maxeo/3dprint-supporto-tablet/stl/supporto_assemblato.stl

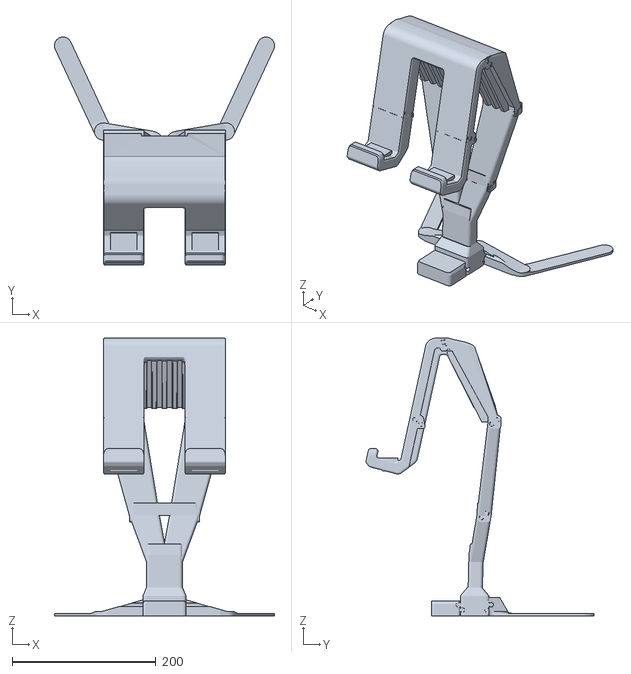
[picture p1: CAD file, 2026-09-29]
stl/supporto_assemblato.stl
306.5 x 317.3 x 386.9
