maxeo/3dprint-supporto-tablet/originale/obj_1_raised_phone_stand2.stl

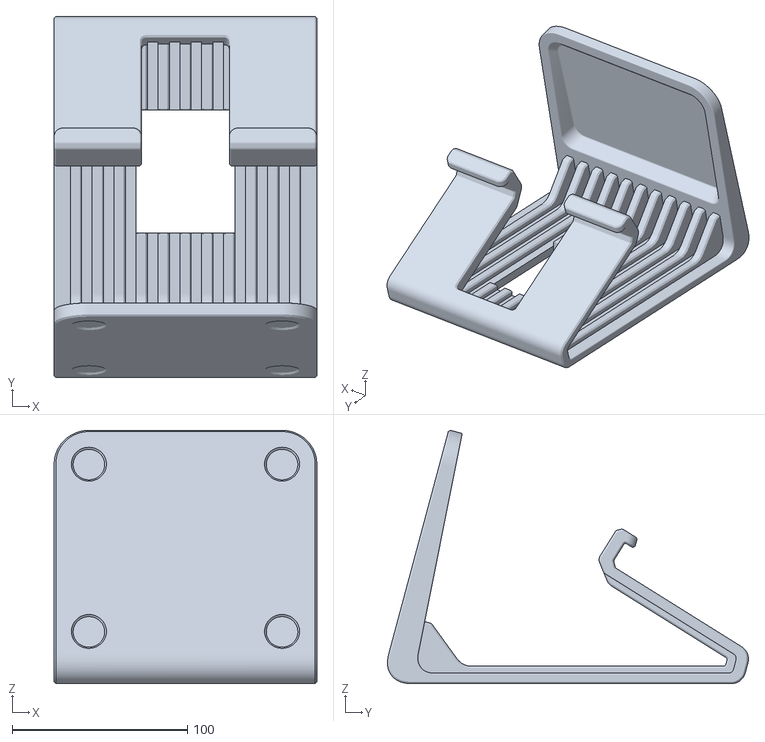
[picture p2: CAD file, 2026-09-13]
originale/obj_1_raised_phone_stand2.stl
150.0 x 206.1 x 144.6
