maxeo/3dprint-supporto-tablet/prove/provino_B_x1.stl

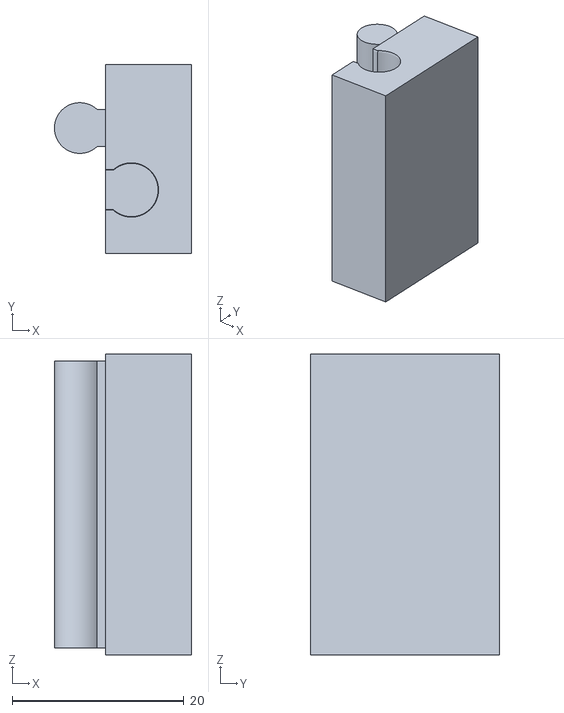
[picture p3: CAD file, 2026-09-13]
prove/provino_B_x1.stl
16.0 x 22.0 x 35.0
