maxeo/3dprint-supporto-tablet/stl/pezzi_singoli/B01_piede_anteriore_corto_x1.stl

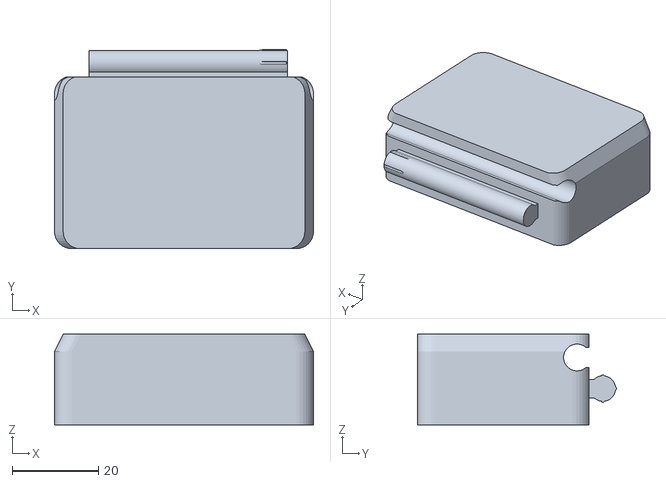
[picture p4: CAD file, 2026-09-29]
stl/pezzi_singoli/B01_piede_anteriore_corto_x1.stl
60.0 x 46.2 x 21.0
