maxeo/3dprint-supporto-tablet/stl/tutti_i_pezzi_separati.stl

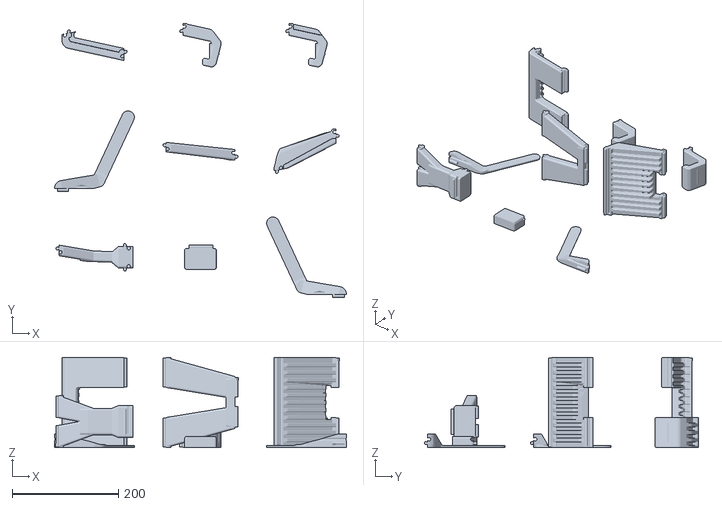
[picture p5: CAD file, 2026-09-29]
stl/tutti_i_pezzi_separati.stl
550.7 x 517.6 x 170.0
