maxeo/3dprint-supporto-tablet/stl/varianti/S05_schienale_unico_x1.stl

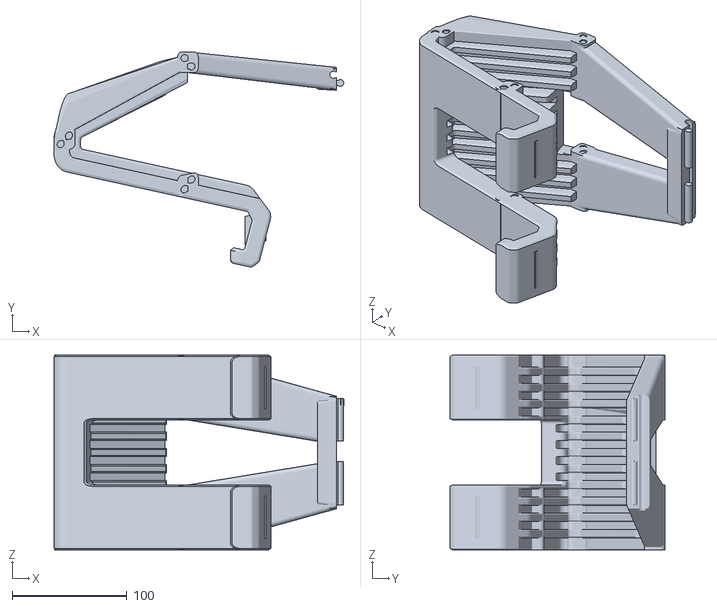
[picture p6: CAD file, 2026-09-29]
stl/varianti/S05_schienale_unico_x1.stl
253.1 x 187.8 x 170.0
