maxeo/3dprint-supporto-tablet/prove/provino_A_x1.stl

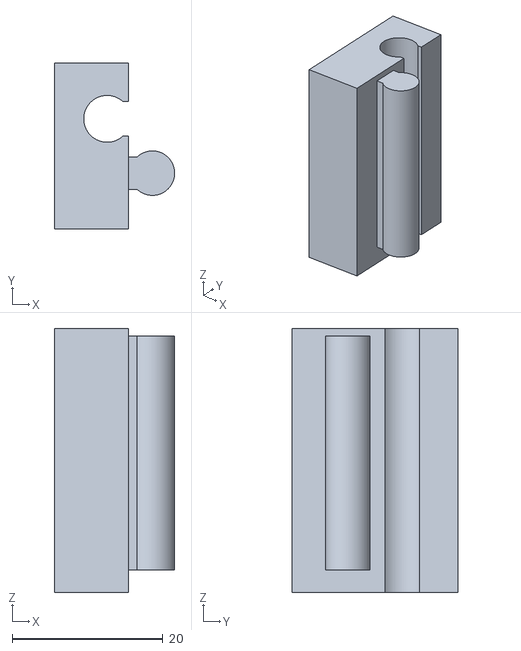
[picture p7: CAD file, 2026-09-13]
prove/provino_A_x1.stl
16.0 x 22.0 x 35.0
