maxeo/3dprint-supporto-tablet/stl/pezzi_singoli/A01_appoggio_sinistro_x1.stl

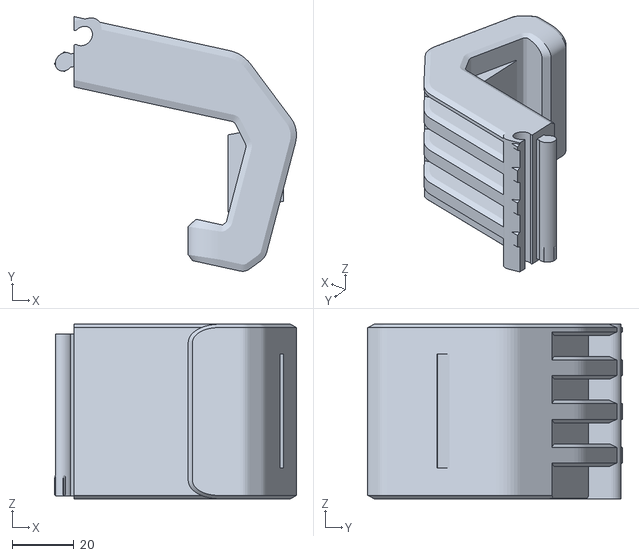
[picture p8: CAD file, 2026-09-29]
stl/pezzi_singoli/A01_appoggio_sinistro_x1.stl
78.5 x 82.6 x 56.7
