maxeo/3dprint-supporto-tablet/stl/varianti/A03_appoggio_unico_x1.stl

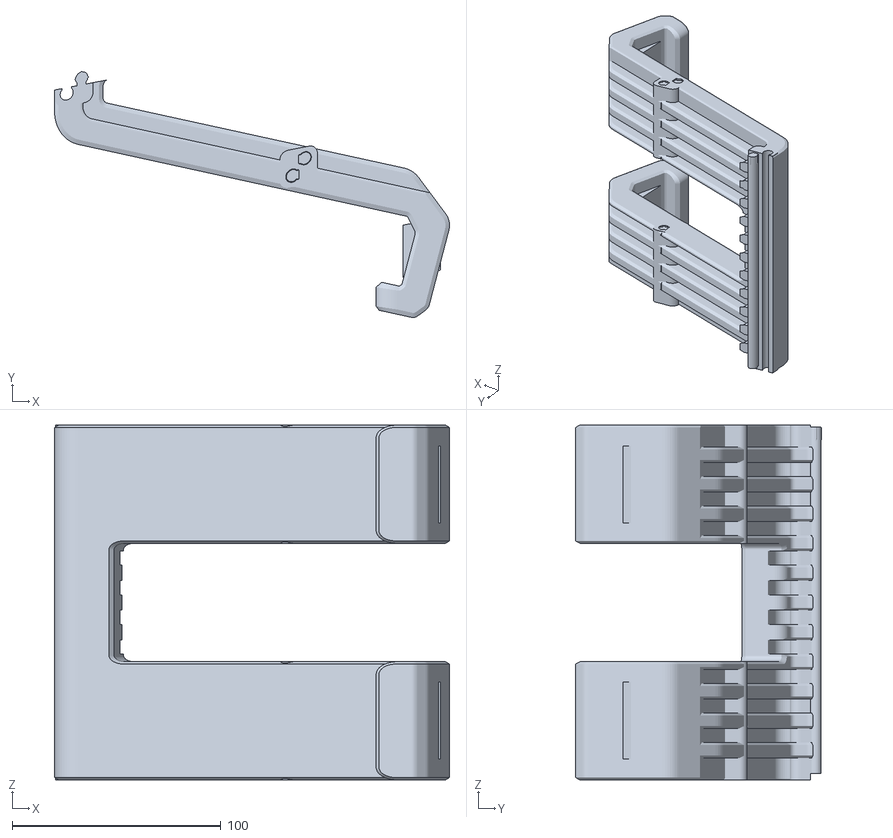
[picture p9: CAD file, 2026-09-29]
stl/varianti/A03_appoggio_unico_x1.stl
189.2 x 117.9 x 170.0
