maxeo/3dprint-supporto-tablet/stl/pezzi_singoli/S01_schienale_a_y_x1.stl

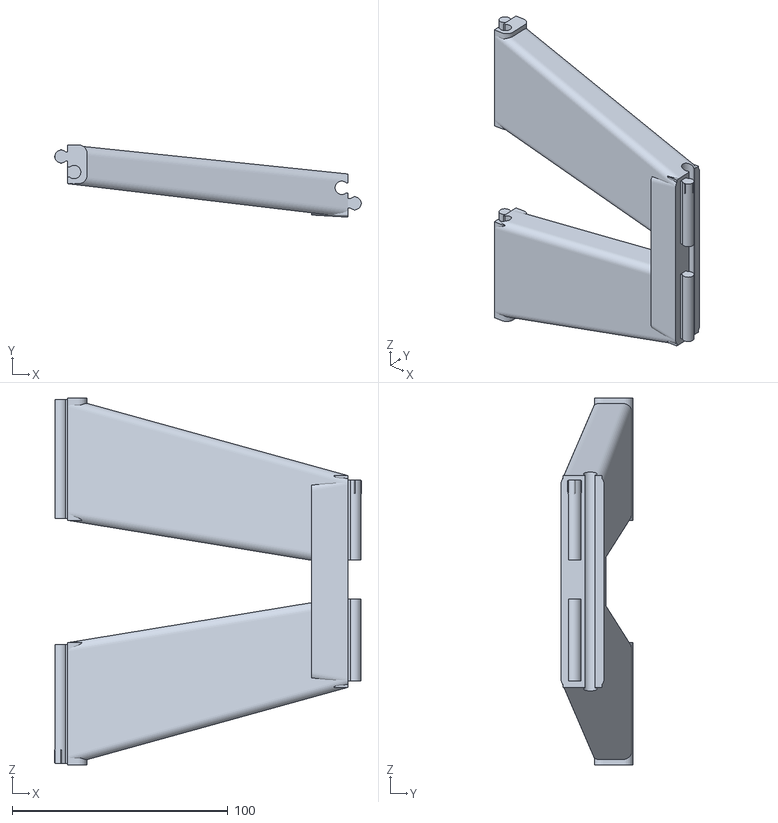
[picture p10: CAD file, 2026-09-29]
stl/pezzi_singoli/S01_schienale_a_y_x1.stl
142.4 x 33.5 x 170.0
