maxeo/3dprint-supporto-tablet/stl/varianti/B06_raccordo_con_piede_x1.stl

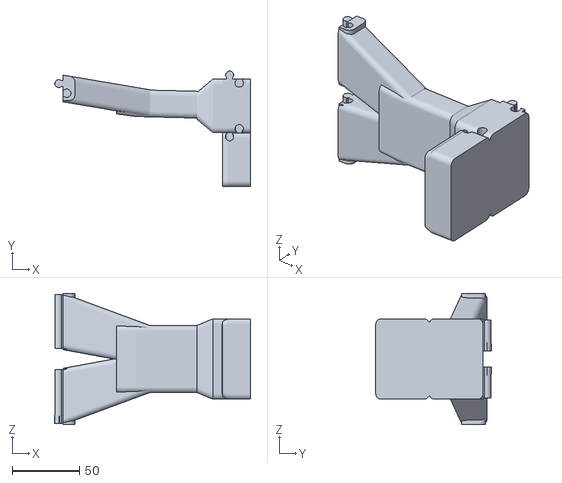
[picture p11: CAD file, 2026-09-29]
stl/varianti/B06_raccordo_con_piede_x1.stl
146.2 x 86.2 x 98.0
