maxeo/3dprint-supporto-tablet/stl/pezzi_singoli/B05_gamba_posteriore_destra_x1.stl

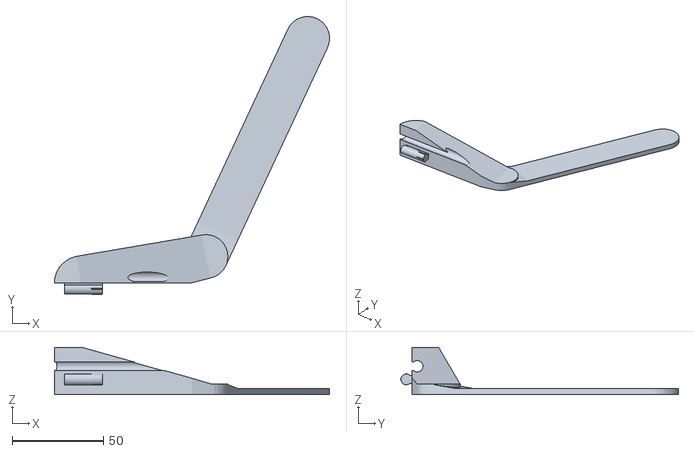
[picture p12: CAD file, 2026-09-29]
stl/pezzi_singoli/B05_gamba_posteriore_destra_x1.stl
150.7 x 152.3 x 26.0
