maxeo/3dprint-supporto-tablet/stl/varianti/S04_testa_unica_x1.stl

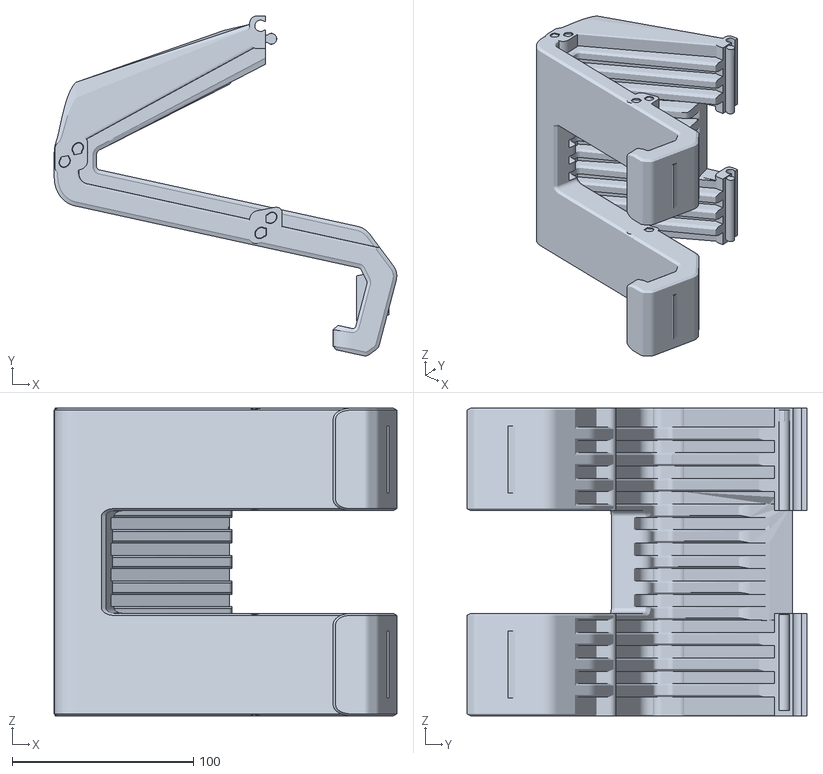
[picture p13: CAD file, 2026-09-29]
stl/varianti/S04_testa_unica_x1.stl
189.2 x 187.8 x 170.0
