maxeo/3dprint-supporto-tablet/stl/pezzi_singoli/S03_appoggio_superiore_anteriore_x1.stl

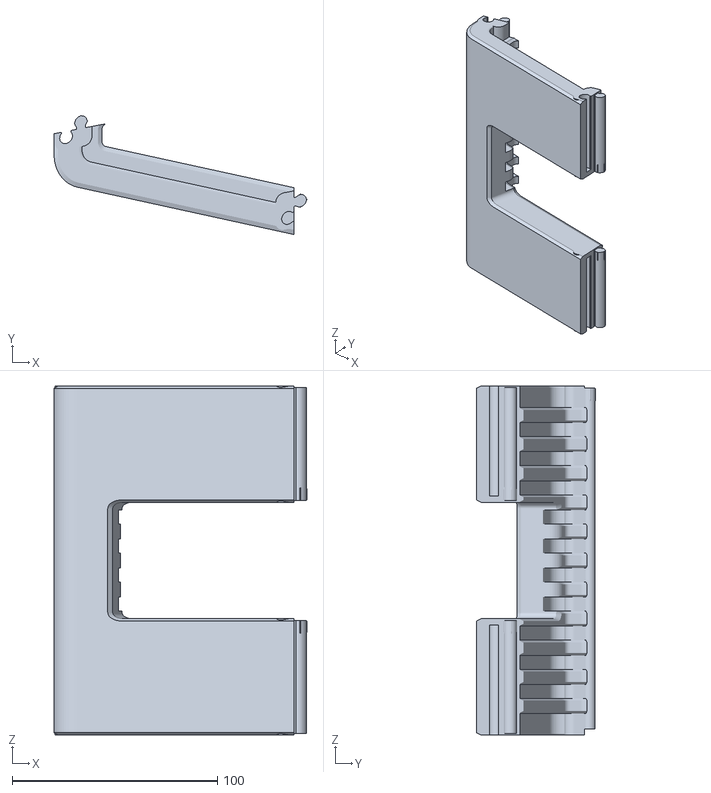
[picture p14: CAD file, 2026-09-29]
stl/pezzi_singoli/S03_appoggio_superiore_anteriore_x1.stl
123.1 x 58.0 x 170.0
