maxeo/3dprint-supporto-tablet/stl/pezzi_singoli/B03_raccordo_centrale_blu_x1.stl

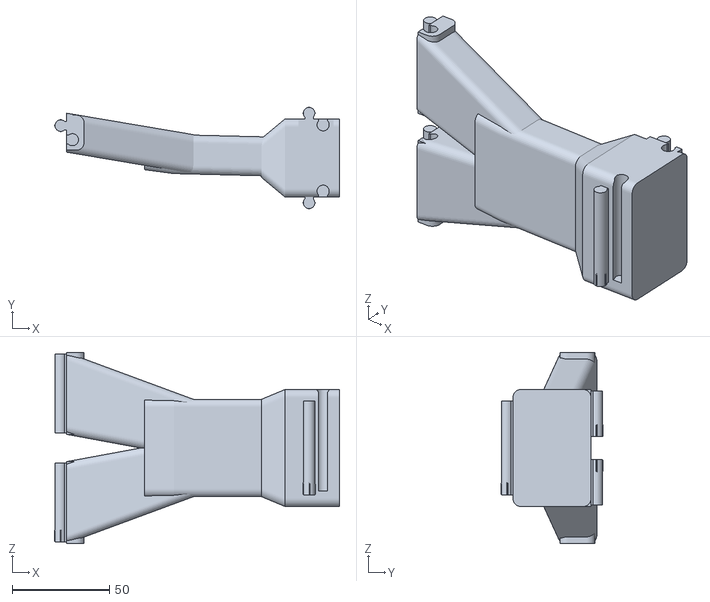
[picture p15: CAD file, 2026-09-29]
stl/pezzi_singoli/B03_raccordo_centrale_blu_x1.stl
146.2 x 52.4 x 98.0
