maxeo/3dprint-supporto-tablet/stl/pezzi_singoli/S02_schienale_superiore_posteriore_x1.stl

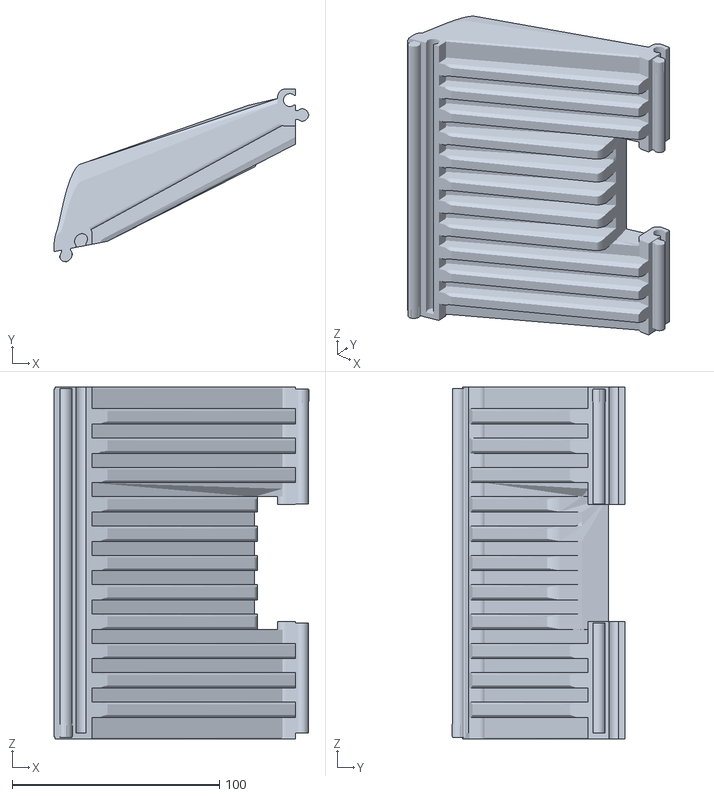
[picture p16: CAD file, 2026-09-29]
stl/pezzi_singoli/S02_schienale_superiore_posteriore_x1.stl
123.1 x 83.7 x 170.0
