maxeo/3dprint-supporto-tablet/(list of files, cad)

Other CAD files:
prove/tolleranze/V7_G015CR_B_nervature.stl
prove/tolleranze/V7_G015CR_A_nervature.stl
prove/tolleranze/V7_G015_A_piolo_maggiorato.stl
prove/tolleranze/V7_G015_B_piolo_maggiorato.stl
prove/tolleranze/V7_G010_B_piolo_maggiorato.stl
prove/tolleranze/V7_G010_A_piolo_maggiorato.stl
stl/pezzi_singoli/A02_appoggio_destro_x1.stl
stl/pezzi_singoli/B04_gamba_posteriore_sinistra_x1.stl
blender/supporto_22cm.blend
prove/tolleranze/provini_G015CR.blend
