maxeo/3dprint-supporto-tablet/(commit log)

2026-09-13 Aggiunto il README con il link alla guida online
    - Aggiunto il collegamento alla guida pubblicata su GitHub Pages
    - Descritti i contenuti delle cartelle del progetto
2026-09-26 Riorganizzati i file del progetto in cartelle
    - Spostati gli STL in stl, il blend in blender e i JSON in dati
    - Spostati istruzioni e SVG in documenti
    - Aggiornati i percorsi in guida, README e JSON
    [A01_appoggio_sinistro_x1.stl, A02_appoggio_destro_x1.stl, B01_piede_anteriore_corto_x1.stl, B03_raccordo_centrale_blu_x1.stl, B04_gamba_posteriore_sinistra_x1.stl, B05_gamba_posteriore_destra_x1.stl, S01_schienale_a_y_x1.stl, S02_schienale_superiore_posteriore_x1.stl]
2026-09-26 Aggiunto il tema chiaro e scuro alla guida
    - Pulsante Sistema, Chiaro, Scuro con scelta condivisa tra le guide
2026-09-27 Aggiunto il pulsante Stampante alla guida
    - Area di stampa condivisa fra le guide e avviso sui pezzi che non entrano
2026-09-27 Aggiornato il controllo della stampante nella guida
    - Letti anche i pezzi con dimensions_mm
2026-09-27 Aggiunta la ricerca delle stampanti nella guida
    - Elenco di ~390 stampanti dai profili OrcaSlicer, con parole evidenziate
    - Pulsanti in cima alla pagina su mobile e margine sotto l'avviso
2026-09-27 Aggiunto sfondo chiaro agli schemi nel tema scuro
    - Schemi delle note leggibili anche con il tema scuro
2026-09-27 Resa leggibile la riga selezionata nel tema scuro
    - Riga selezionata della lista di stampa con sfondo scuro
2026-09-27 Aggiunti i passaggi animati e resa più fluida la vista 3D
    - Aggiunti i passaggi accanto alla vista con animazione di inserimento e pulsante Rivedi
    - Mostrati nei passaggi solo i pezzi già montati
    - Sostituito il disegno per triangoli con uno z-buffer per pixel, circa 10 volte più veloce
    - Corretto il numero dei passaggi nel testo iniziale
2026-09-27 Aggiunte le varianti con meno pezzi e riordinato il Blender
    - Aggiunto il pulsante Varianti nella guida: parte alta e base scelte a parte, da 9 a 4 pezzi
    - Aggiunti gli STL uniti A03, S04, S05 e B06 con misure in dati/varianti.json
    - Aggiunto blender/varianti.py che unisce i moduli e riempie il gioco dei giunti interni
    - Riordinato il file Blender in scene Montaggio e Stampa con collezioni per gruppo
    - Unificati i materiali e ripuliti i nomi di oggetti e mesh
    - Aggiornato il README con la sezione sulle varianti
    [A03_appoggio_unico_x1.stl, B06_raccordo_con_piede_x1.stl, S04_testa_unica_x1.stl, S05_schienale_unico_x1.stl, supporto_22cm.blend]
2026-09-29 Aggiunte le nervature da schiacciare agli incastri V7
    - Aggiunte 3 nervature per lobo (Ø0,8 mm, sporgenza 0,25 mm) sui 16 lobi maschi, solo verso la battuta
    - Aggiunto lo script blender/nervature.py con verifica di sfilamento e dati/nervature.json
    - Aggiunti i provini G015CR con nervature in prove/tolleranze
    - Rigenerati STL dei moduli, assemblato, pezzi separati e varianti
    - Corretta la pulizia di schegge e triangoli degeneri in varianti.py
    - Aggiornate misure e istruzioni in guida, README e documenti
    [A01_appoggio_sinistro_x1.stl, A02_appoggio_destro_x1.stl, A03_appoggio_unico_x1.stl, B01_piede_anteriore_corto_x1.stl, B03_raccordo_centrale_blu_x1.stl, B04_gamba_posteriore_sinistra_x1.stl, B05_gamba_posteriore_destra_x1.stl, B06_raccordo_con_piede_x1.stl]
